hernanporrini/GPSDO/EU1_000484.jpg

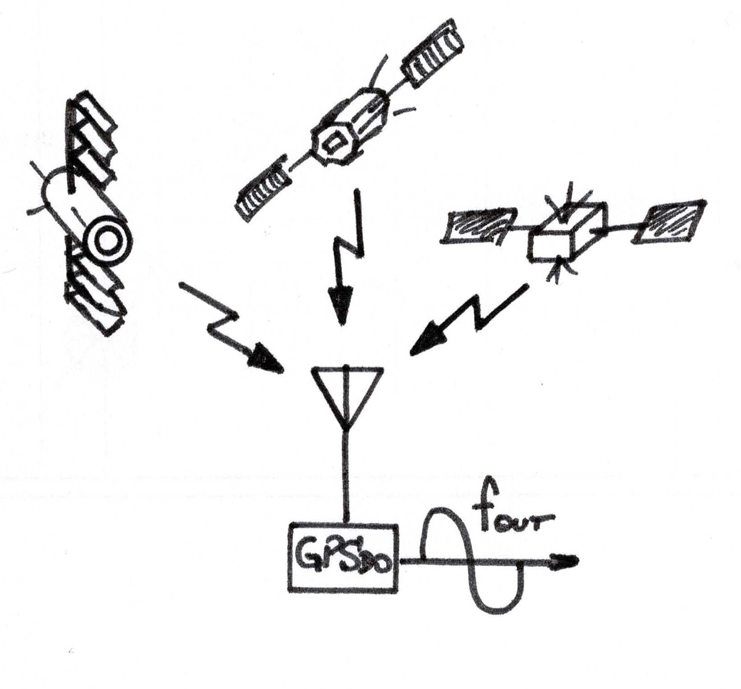
EU1_000484.jpg
